akabla/I2C_Lab/PROTOTYPE/photos/bus_controller_circuit_drawing.jpeg

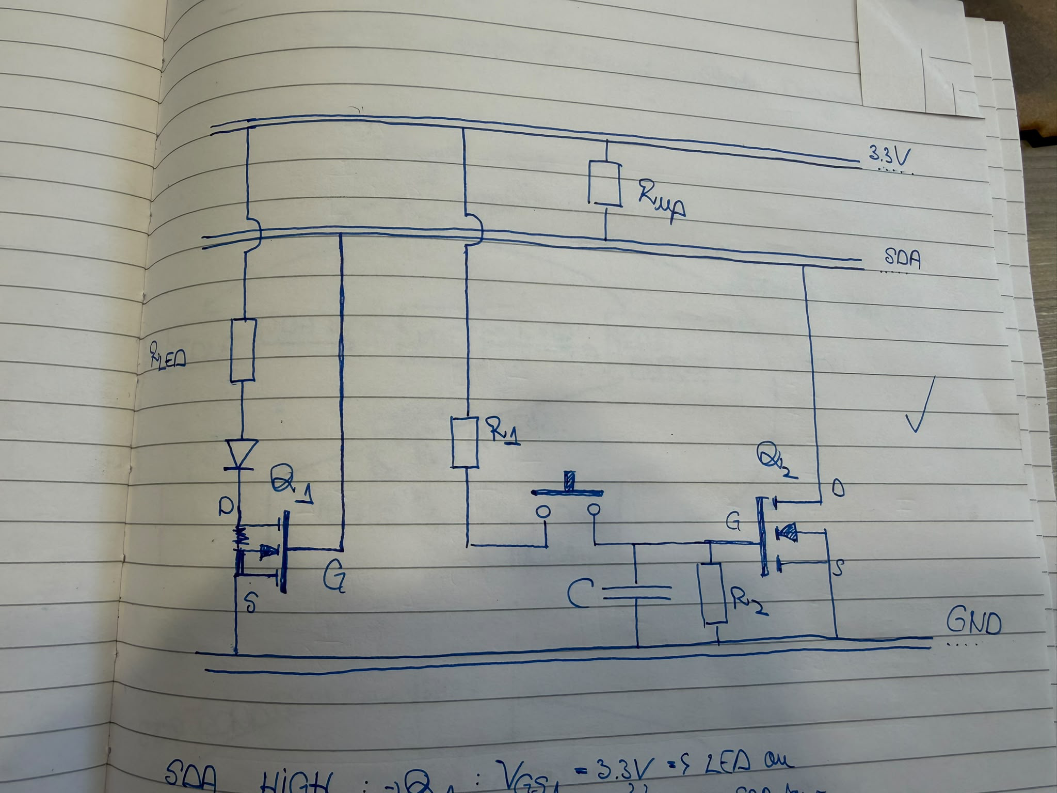
PROTOTYPE/photos/bus_controller_circuit_drawing.jpeg
