akabla/I2C_Lab/PROTOTYPE/photos/listener_and_target_prototype.jpeg

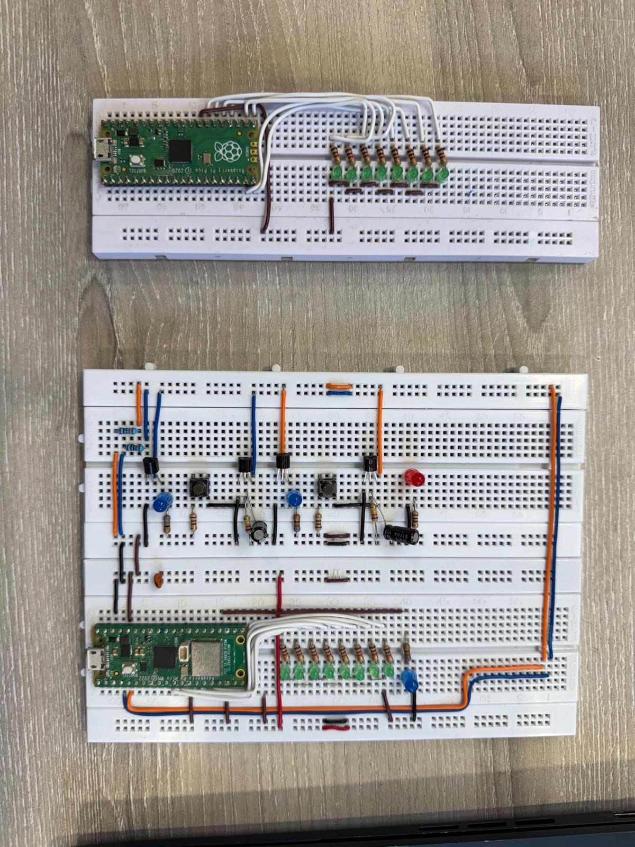
PROTOTYPE/photos/listener_and_target_prototype.jpeg
