akabla/I2C_Lab/PROTOTYPE/OpenScad Boxes/i2c_modular_design_boxes/bus/bus_box_flattened.dxf

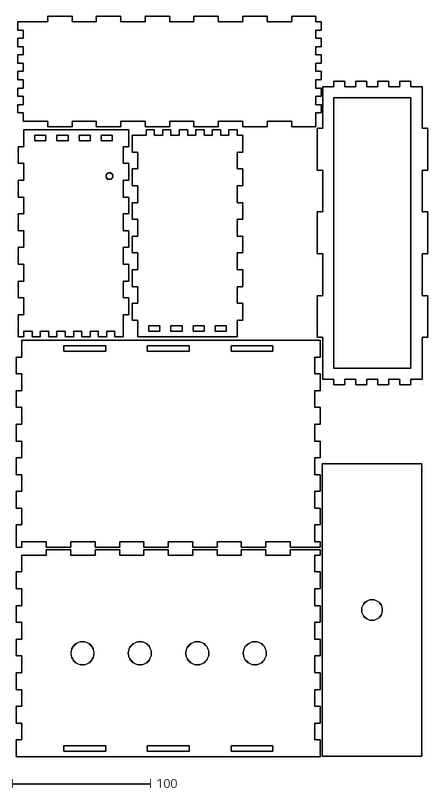
[picture p10: CAD file, 2026-08-28]
PROTOTYPE/OpenScad Boxes/i2c_modular_design_boxes/bus/bus_box_flattened.dxf
297.8 x 536.4
