akabla/I2C_Lab/PROTOTYPE/OpenScad Boxes/i2c_modular_design_boxes/controller/controller_box_to_lasercut.dxf

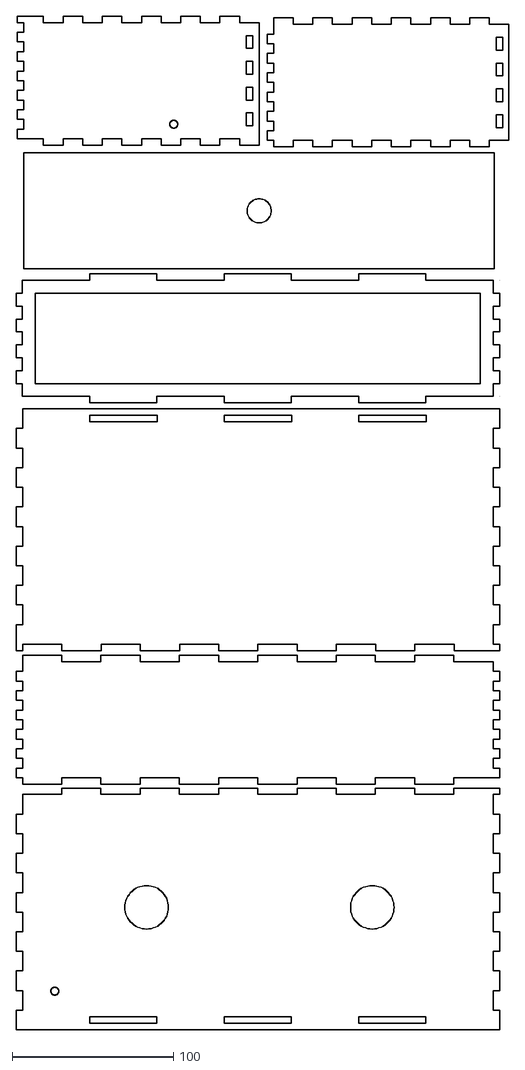
[picture p11: CAD file, 2026-08-28]
PROTOTYPE/OpenScad Boxes/i2c_modular_design_boxes/controller/controller_box_to_lasercut.dxf
305.8 x 628.9
