akabla/I2C_Lab/PROTOTYPE/OpenScad Boxes/i2c_modular_design_boxes/listener/listener_box_to_lasercut.dxf

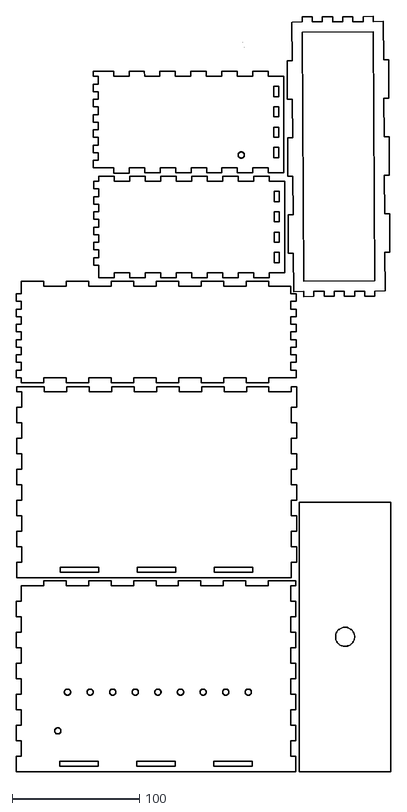
[picture p12: CAD file, 2026-08-28]
PROTOTYPE/OpenScad Boxes/i2c_modular_design_boxes/listener/listener_box_to_lasercut.dxf
294.7 x 594.0
