akabla/I2C_Lab/PROTOTYPE/OpenScad Boxes/i2c_modular_design_boxes/listener_target_controller_to_lasercut.dxf

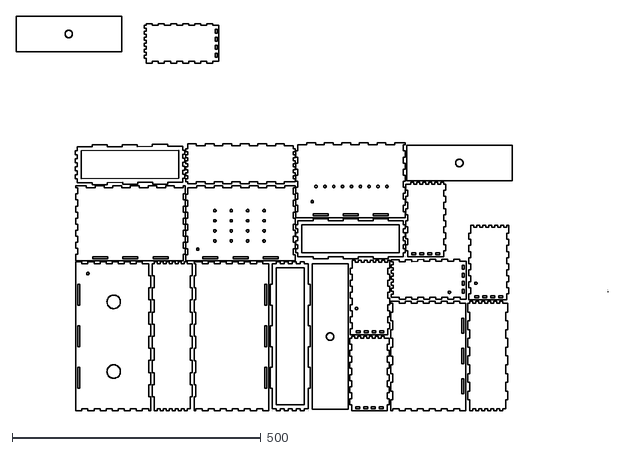
[picture p13: CAD file, 2026-08-28]
PROTOTYPE/OpenScad Boxes/i2c_modular_design_boxes/listener_target_controller_to_lasercut.dxf
1189.4 x 793.4
