akabla/I2C_Lab/PROTOTYPE/OpenScad Boxes/i2c_modular_design_boxes/target/target_box_to_lasercut.dxf

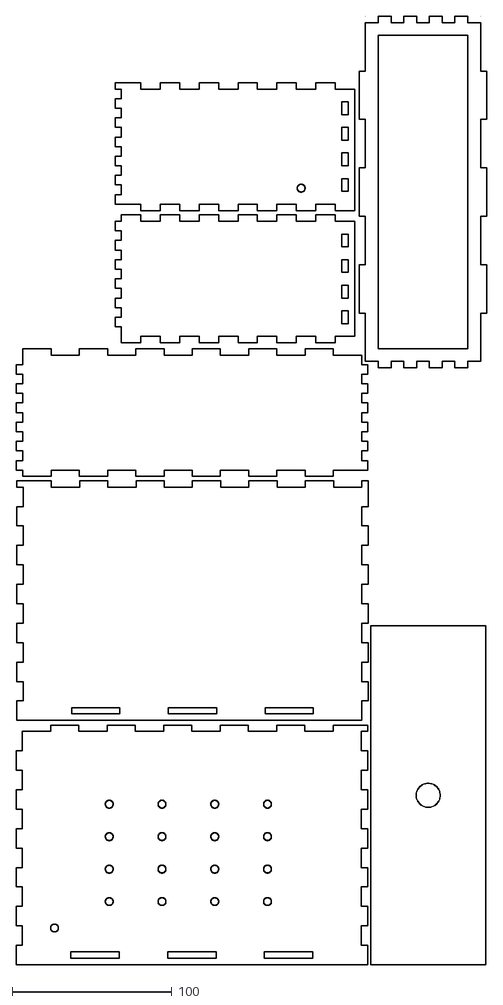
[picture p14: CAD file, 2026-08-28]
PROTOTYPE/OpenScad Boxes/i2c_modular_design_boxes/target/target_box_to_lasercut.dxf
294.6 x 593.6
