akabla/I2C_Lab/(list of files, cad)

Other CAD files:
PROTOTYPE/OpenScad Boxes/box_no_holes.scad
PROTOTYPE/OpenScad Boxes/i2c_modular_design_boxes/bus/bus_box_flattened.scad
PROTOTYPE/OpenScad Boxes/i2c_modular_design_boxes/listener/listener_box_flattened.scad
PROTOTYPE/OpenScad Boxes/i2c_modular_design_boxes/target/target_box_flattened.scad
