akabla/I2C_Lab/(commit log)

2026-08-28 code and box design for the prototype
    note the build folders are missing because they are too big
    [box_no_holes.scad, box_no_holes_flattened.scad, bus_box_flattened.dxf, bus_box_flattened.scad, controller_box.scad, controller_box_to_lasercut.dxf, listener_box_flattened.scad, listener_box_to_lasercut.dxf]
2026-09-04 Rename I2C_Device_Documentation (3).pdf to I2C_DOCUMENTATION
